eyallampel1/stm32_evb/stm32.kicad_pcb

## KiCad design stm32.kicad_pcb (2025-04-07)

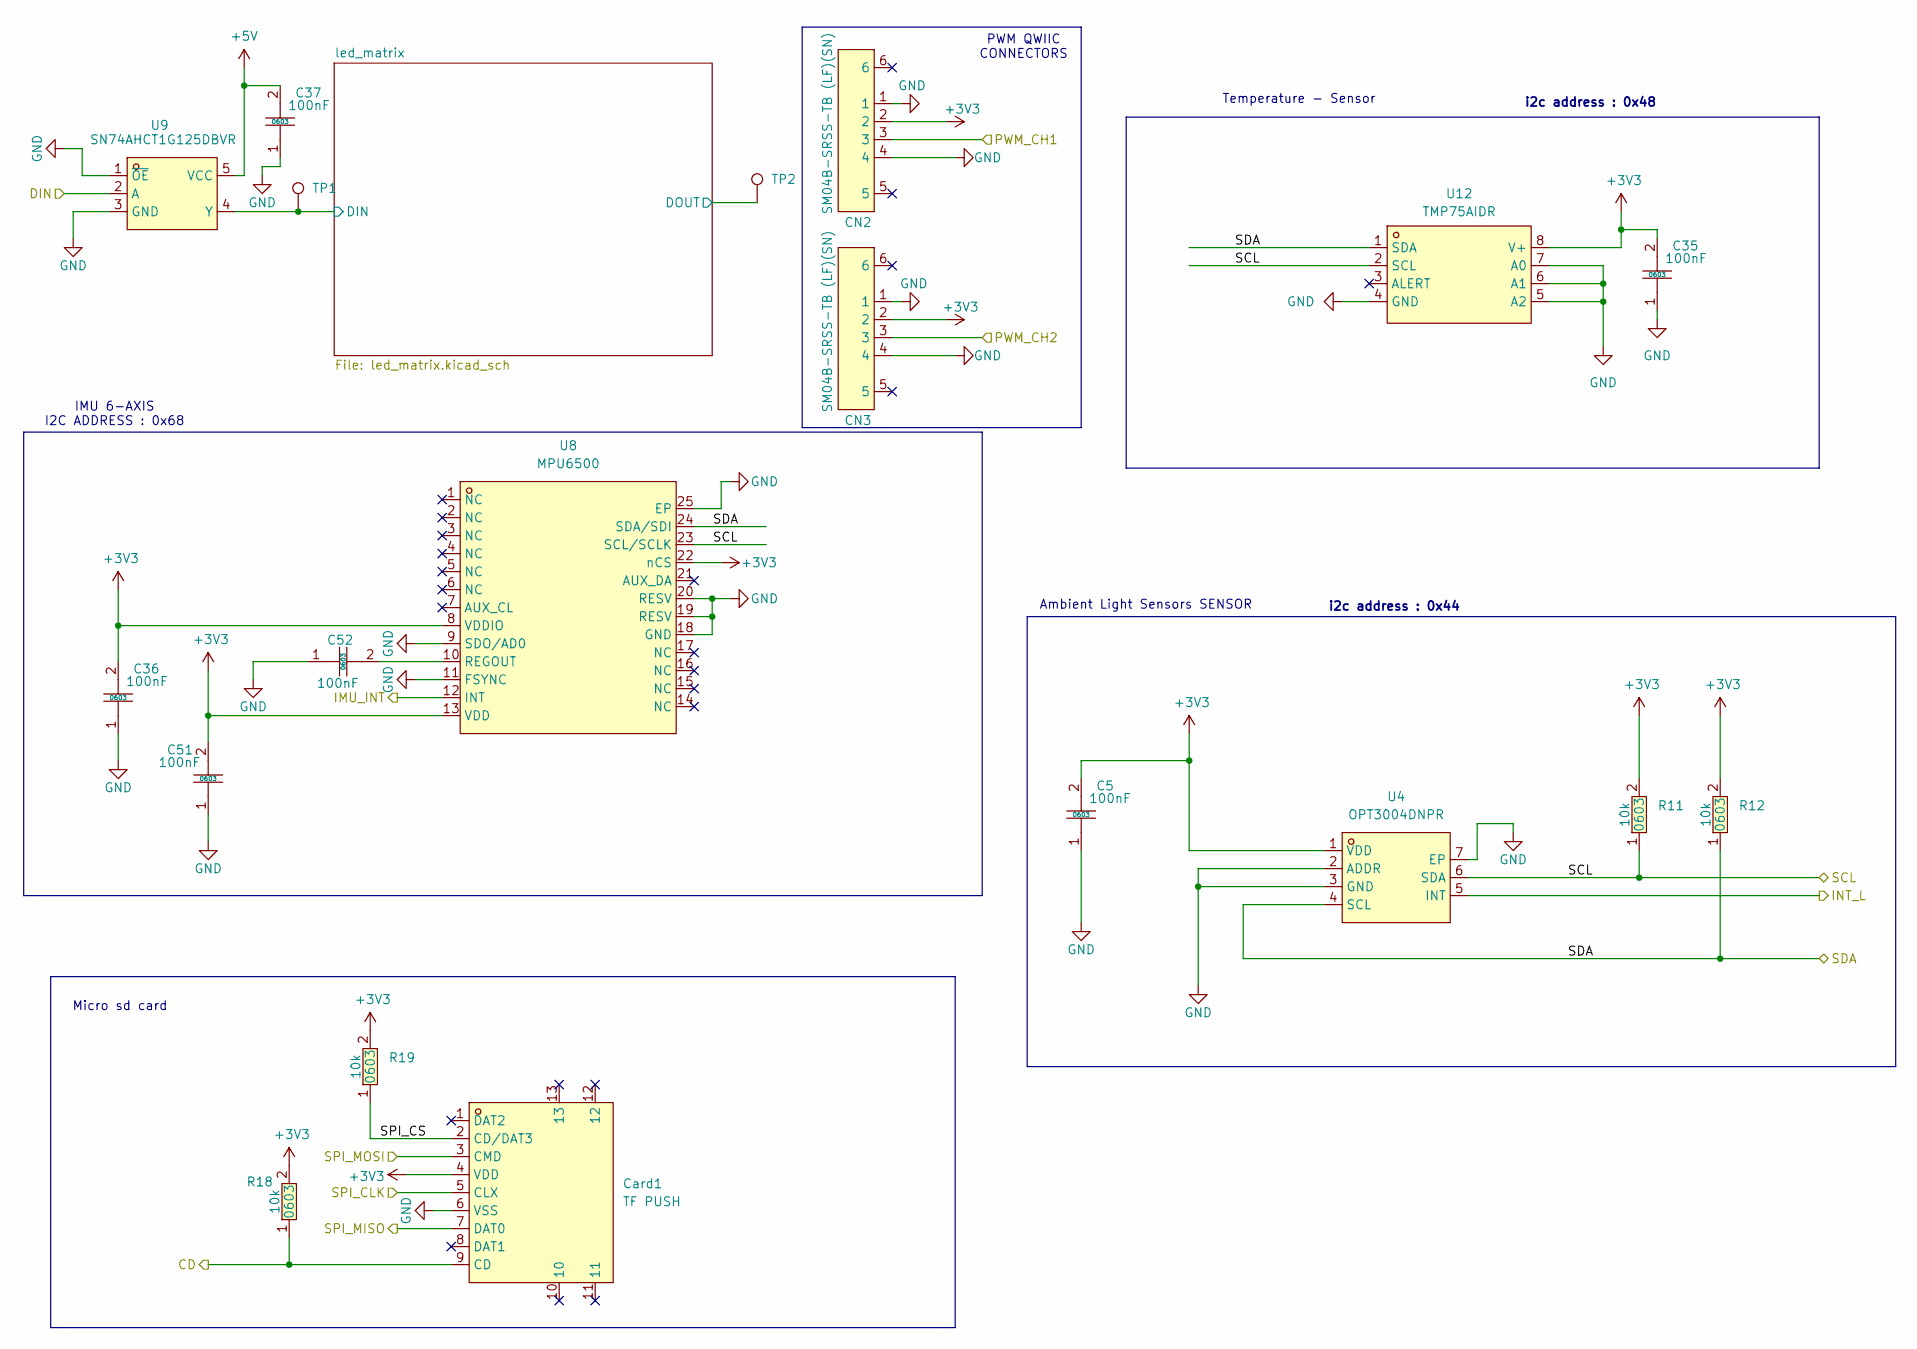
[picture p1: schematic sensors.kicad_sch]

Parts:
C5, C35, C36, C37, C51, C52: CC0603KRX7R9BB104; C0603; LCSC Part C14663
CN2, CN3: SM04B-SRSS-TB (LF)(SN); CONN-SMD_4P-P1.00_SM04B-SRSS-TB-LF-SN; LCSC Part C160404
Card1: TF PUSH; TF-SMD_TF-PUSH; LCSC Part C393941
R11, R12, R18, R19: 0603WAF1002T5E; R0603; LCSC Part C25804
TP1, TP2: TestPoint; TestPoint_Pad_2.0x2.0mm
U4: OPT3004DNPR; WSON-6_L2.0-W2.0-P0.65-TL-EP; LCSC Part C2655153
U8: MPU6500; QFN-24_L3.0-W3.0-P0.40-BL-EP; LCSC Part C50278
U9: SN74AHCT1G125DBVR; SOT-23-5_L3.0-W1.7-P0.95-LS2.8-BR; LCSC Part C7484
U12: TMP75AIDR; SOIC-8_L4.9-W3.9-P1.27-LS6.0-BL; LCSC Part C30389

Connections:
+3V3: C5.2, C35.2, C36.2, C51.2, CN2.2, CN3.2, Card1.4 (VDD), R11.2, R12.2, R18.2, R19.2, U4.1 (VDD), U8.8 (VDDIO), U8.13 (VDD), U8.22 (nCS), U12.8 (V+); also elsewhere on the board
+5V: C37.2, U9.5 (VCC); also elsewhere on the board
/sensors/SCL: R11.1, U4.6 (SDA), U8.23 (SCL/SCLK), U12.2 (SCL); also elsewhere on the board
/sensors/SDA: R12.1, U4.4 (SCL), U8.24 (SDA/SDI), U12.1 (SDA); also elsewhere on the board
/sensors/SPI_CS: Card1.2 (CD/DAT3), R19.1
/sensors/led_matrix/DIN: TP1.1, U9.4 (Y); also elsewhere on the board
/sensors/led_matrix/DOUT: TP2.1; also elsewhere on the board
/stm32_page/IMU_INT: U8.12 (INT); also elsewhere on the board
/stm32_page/PWM_CH1: CN2.3; also elsewhere on the board
/stm32_page/PWM_CH4: CN3.3; also elsewhere on the board
/stm32_page/RGB_LEDS: U9.2 (A); also elsewhere on the board
/stm32_page/SD_CD: Card1.9 (CD), R18.1; also elsewhere on the board
/stm32_page/SPI1_MISO: Card1.7 (DAT0); also elsewhere on the board
/stm32_page/SPI1_MOSI: Card1.3 (CMD); also elsewhere on the board
/stm32_page/SPI1_SCK: Card1.5 (CLX); also elsewhere on the board
/stm32_page/SYS_WKUP1: U4.5 (INT); also elsewhere on the board
GND: C5.1, C35.1, C36.1, C37.1, C51.1, C52.1, CN2.1, CN2.4, CN3.1, CN3.4, Card1.6 (VSS), U4.2 (ADDR), U4.3 (GND), U4.7 (EP), U8.9 (SDO/AD0), U8.11 (FSYNC), U8.18 (GND), U8.19 (RESV), U8.20 (RESV), U8.25 (EP), U9.1 (~OE), U9.3 (GND), U12.4 (GND), U12.5 (A2), U12.6 (A1), U12.7 (A0); also elsewhere on the board
unnamed: C52.2, U8.10 (REGOUT)

Notes on the sheet:
PWM QWIIC CONNECTORS
Temperature - Sensor
i2c address : 0x48
Ambient Light Sensors SENSOR
IMU 6-AXIS I2C ADDRESS : 0x68
i2c address : 0x44
Micro sd card

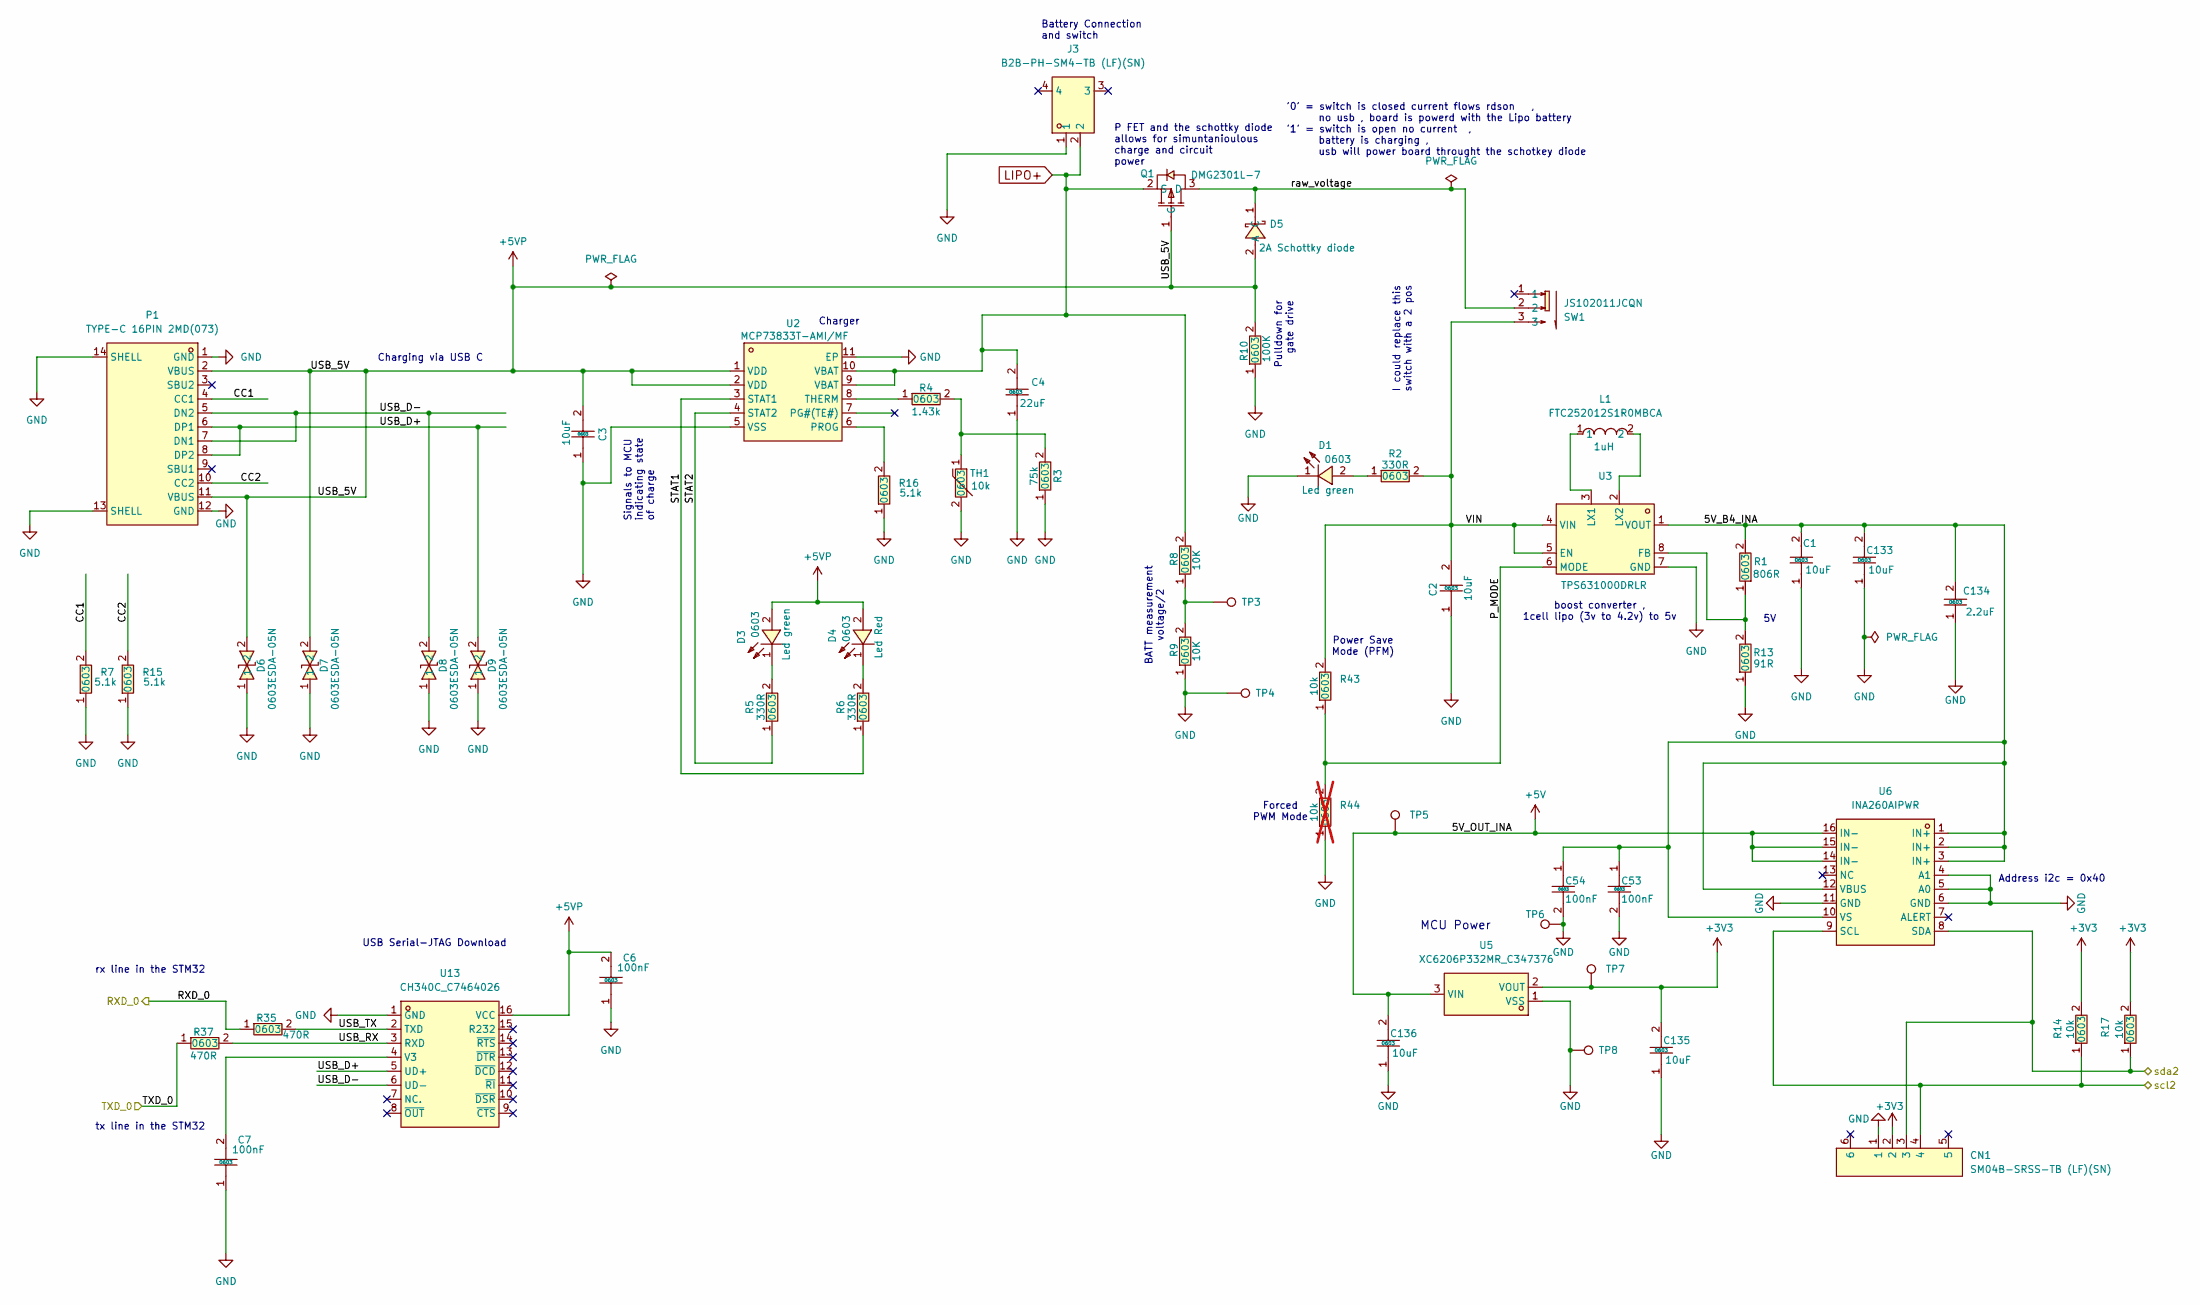
[picture p2: schematic usb_power.kicad_sch]

Parts:
C1, C2, C3, C133, C135, C136: CL10A106KP8NNNC; C0603; LCSC Part C19702
C4: CL10A226MP8NUNE; C0603; LCSC Part C86295
C6, C7, C53, C54: CC0603KRX7R9BB104; C0603; LCSC Part C14663
C134: CL10A225KO8NNNC; C0603; LCSC Part C23630
CN1: SM04B-SRSS-TB (LF)(SN); CONN-SMD_4P-P1.00_SM04B-SRSS-TB-LF-SN; LCSC Part C160404
D1, D3: 0603 Green 509-620mcd; LED0603-RD; LCSC Part C12624
D4: KT-0603R; LED0603-RD; LCSC Part C2286
D5: MBRA210LT3G_C5337989; SMA_L4.3-W2.6-LS5.1-RD; LCSC Part C5337989
D6, D7, D8, D9: 0603ESDA-05N; D0603-BI; LCSC Part C316054
J3: B2B-PH-SM4-TB (LF)(SN); CONN-SMD_B2B-PH-SM4-TB-LF-SN; LCSC Part C265003
L1: FTC252012S1R0MBCA; IND-SMD_L2.5-W2.0-VLS252012CX-150M; LCSC Part C5832370
P1: TYPE-C 16PIN 2MD(073); USB-C-SMD_TYPE-C-6PIN-2MD-073; LCSC Part C2765186
Q1: DMG2301L-7; SOT-23-3_L2.9-W1.3-P1.90-LS2.4-BR; LCSC Part C102619
R1: 0603WAF8060T5E; R0603; LCSC Part C23116
R2, R5, R6: 0603WAF3300T5E; R0603; LCSC Part C23138
R3: 0603WAF7502T5E; R0603; LCSC Part C23242
R4: 0603WAF1431T5E; R0603; LCSC Part C22840
R7, R15, R16: 0603WAF5101T5E; R0603; LCSC Part C23186
R8, R9, R14, R17, R43: 0603WAF1002T5E; R0603; LCSC Part C25804
R10: 0603WAF1003T5E; R0603; LCSC Part C25803
R13: 0603WAF910JT5E; R0603; LCSC Part C351621
R35, R37: 0603WAF4700T5E; R0603; LCSC Part C23179
R44: 0603WAF1002T5E; R0603; LCSC Part C25804; not fitted
SW1: JS102011JCQN; SW-SMD_JS102011JCQN; LCSC Part C221659
TH1: NCP18XH103F03RB; R0603; LCSC Part C13564
TP3, TP4, TP5, TP6, TP7, TP8: TestPoint; TestPoint_Pad_2.0x2.0mm
U2: MCP73833T-AMI/MF; DFN-10_L3.0-W3.0-P0.50-BL-EP-1; LCSC Part C340160
U3: TPS631000DRLR; SOT-583-8_L2.1-W1.2-P0.50-LS1.6-BL; LCSC Part C5219190
U5: XC6206P332MR_C347376; SOT-23-3_L3.0-W1.7-P0.95-LS2.9-BR; LCSC Part C347376
U6: INA260AIPWR; TSSOP-16_L5.0-W4.4-P0.65-LS6.4-BL-1; LCSC Part C2155885
U13: CH340C_C7464026; SOP-16_L10.0-W3.9-P1.27-LS6.0-BL; LCSC Part C7464026

Connections:
+3V3: C135.2, CN1.2, R14.2, R17.2, TP7.1, U5.2 (VOUT); also elsewhere on the board
+5V: C136.2, TP5.1, U5.3 (VIN), U6.14 (IN-), U6.15 (IN-), U6.16 (IN-); also elsewhere on the board
+5VP: C3.2, C6.2, D3.2 (A), D4.2 (A), D5.2 (A), D6.2, D7.2, P1.2 (VBUS), P1.11 (VBUS), Q1.1 (G), R10.2, U2.1 (VDD), U2.2 (VDD), U13.16 (VCC)
/USB/5V_B4_INA: C1.2, C53.1, C54.1, C133.2, C134.2, R1.2, U3.1 (VOUT), U6.1 (IN+), U6.2 (IN+), U6.3 (IN+), U6.10 (VS), U6.12 (VBUS)
/USB/CC1: P1.4 (CC1), R7.2
/USB/CC2: P1.10 (CC2), R15.2
/USB/P_MODE: R43.1, R44.2, U3.6 (MODE)
/USB/RXD_0: R35.1; also elsewhere on the board
/USB/STAT1: R6.1, U2.3 (STAT1)
/USB/STAT2: R5.1, U2.4 (STAT2)
/USB/TXD_0: R37.1; also elsewhere on the board
/USB/USB_D+: D9.2, P1.6 (DP1), P1.8 (DP2), U13.5 (UD+)
/USB/USB_D-: D8.2, P1.5 (DN2), P1.7 (DN1), U13.6 (UD-)
/USB/USB_RX: R37.2, U13.3 (RXD)
/USB/USB_TX: R35.2, U13.2 (TXD)
/USB/VIN: C2.2, R2.2, R43.2, SW1.3, U3.4 (VIN), U3.5 (EN)
/USB/raw_voltage: D5.1 (C), Q1.3 (D), SW1.2
/stm32_page/I2C3_SCL: CN1.4, R14.1, U6.9 (SCL); also elsewhere on the board
/stm32_page/I2C3_SDA: CN1.3, R17.1, U6.8 (SDA); also elsewhere on the board
GND: C1.1, C2.1, C3.1, C4.1, C6.1, C7.1, C53.2, C54.2, C133.1, C134.1, C135.1, C136.1, CN1.1, D1.1 (K), D6.1, D7.1, D8.1, D9.1, J3.1, P1.1 (GND), P1.12 (GND), P1.13 (SHELL), P1.14 (SHELL), R3.1, R7.1, R9.1, R10.1, R13.1, R15.1, R16.1, R44.1, TH1.2, TP4.1, TP6.1, TP8.1, U2.5 (VSS), U2.11 (EP), U3.7 (GND), U5.1 (VSS), U6.4 (A1), U6.5 (A0), U6.6 (GND), U6.11 (GND), U13.1 (GND); also elsewhere on the board
LIPO+: C4.2, J3.2, Q1.2 (S), R8.2, U2.9 (VBAT), U2.10 (VBAT)
unnamed: D1.2 (A), R2.1
unnamed: D3.1 (K), R5.2
unnamed: D4.1 (K), R6.2
unnamed: R3.2, R4.2, TH1.1
unnamed: R8.1, R9.2, TP3.1
unnamed: R16.2, U2.6 (PROG)
unnamed: R4.1, U2.8 (THERM)
unnamed: R1.1, R13.2, U3.8 (FB)
unnamed: L1.1, U3.3 (LX1)
unnamed: L1.2, U3.2 (LX2)
unnamed: C7.2, U13.4 (V3)

Notes on the sheet:
Charger
Forced PWM Mode
rx line in the STM32
P FET and the schottky diode allows for simuntanioulous charge and circuit power
Pulldown for gate drive
USB Serial-JTAG Download
'0' = switch is closed current flows rdson , no usb , board is powerd with the Lipo battery '1' = switch is open no current , battery is charging , usb will power board throught the schotkey diode
boost converter , 1cell lipo (3v to 4.2v) to 5v
BATT measurement voltage/2
Power Save Mode (PFM)
Battery Connection and switch
Address i2c = 0x40
tx line in the STM32
I could replace this switch with a 2 pos
Signals to MCU indicating state of charge
MCU Power
Charging via USB C

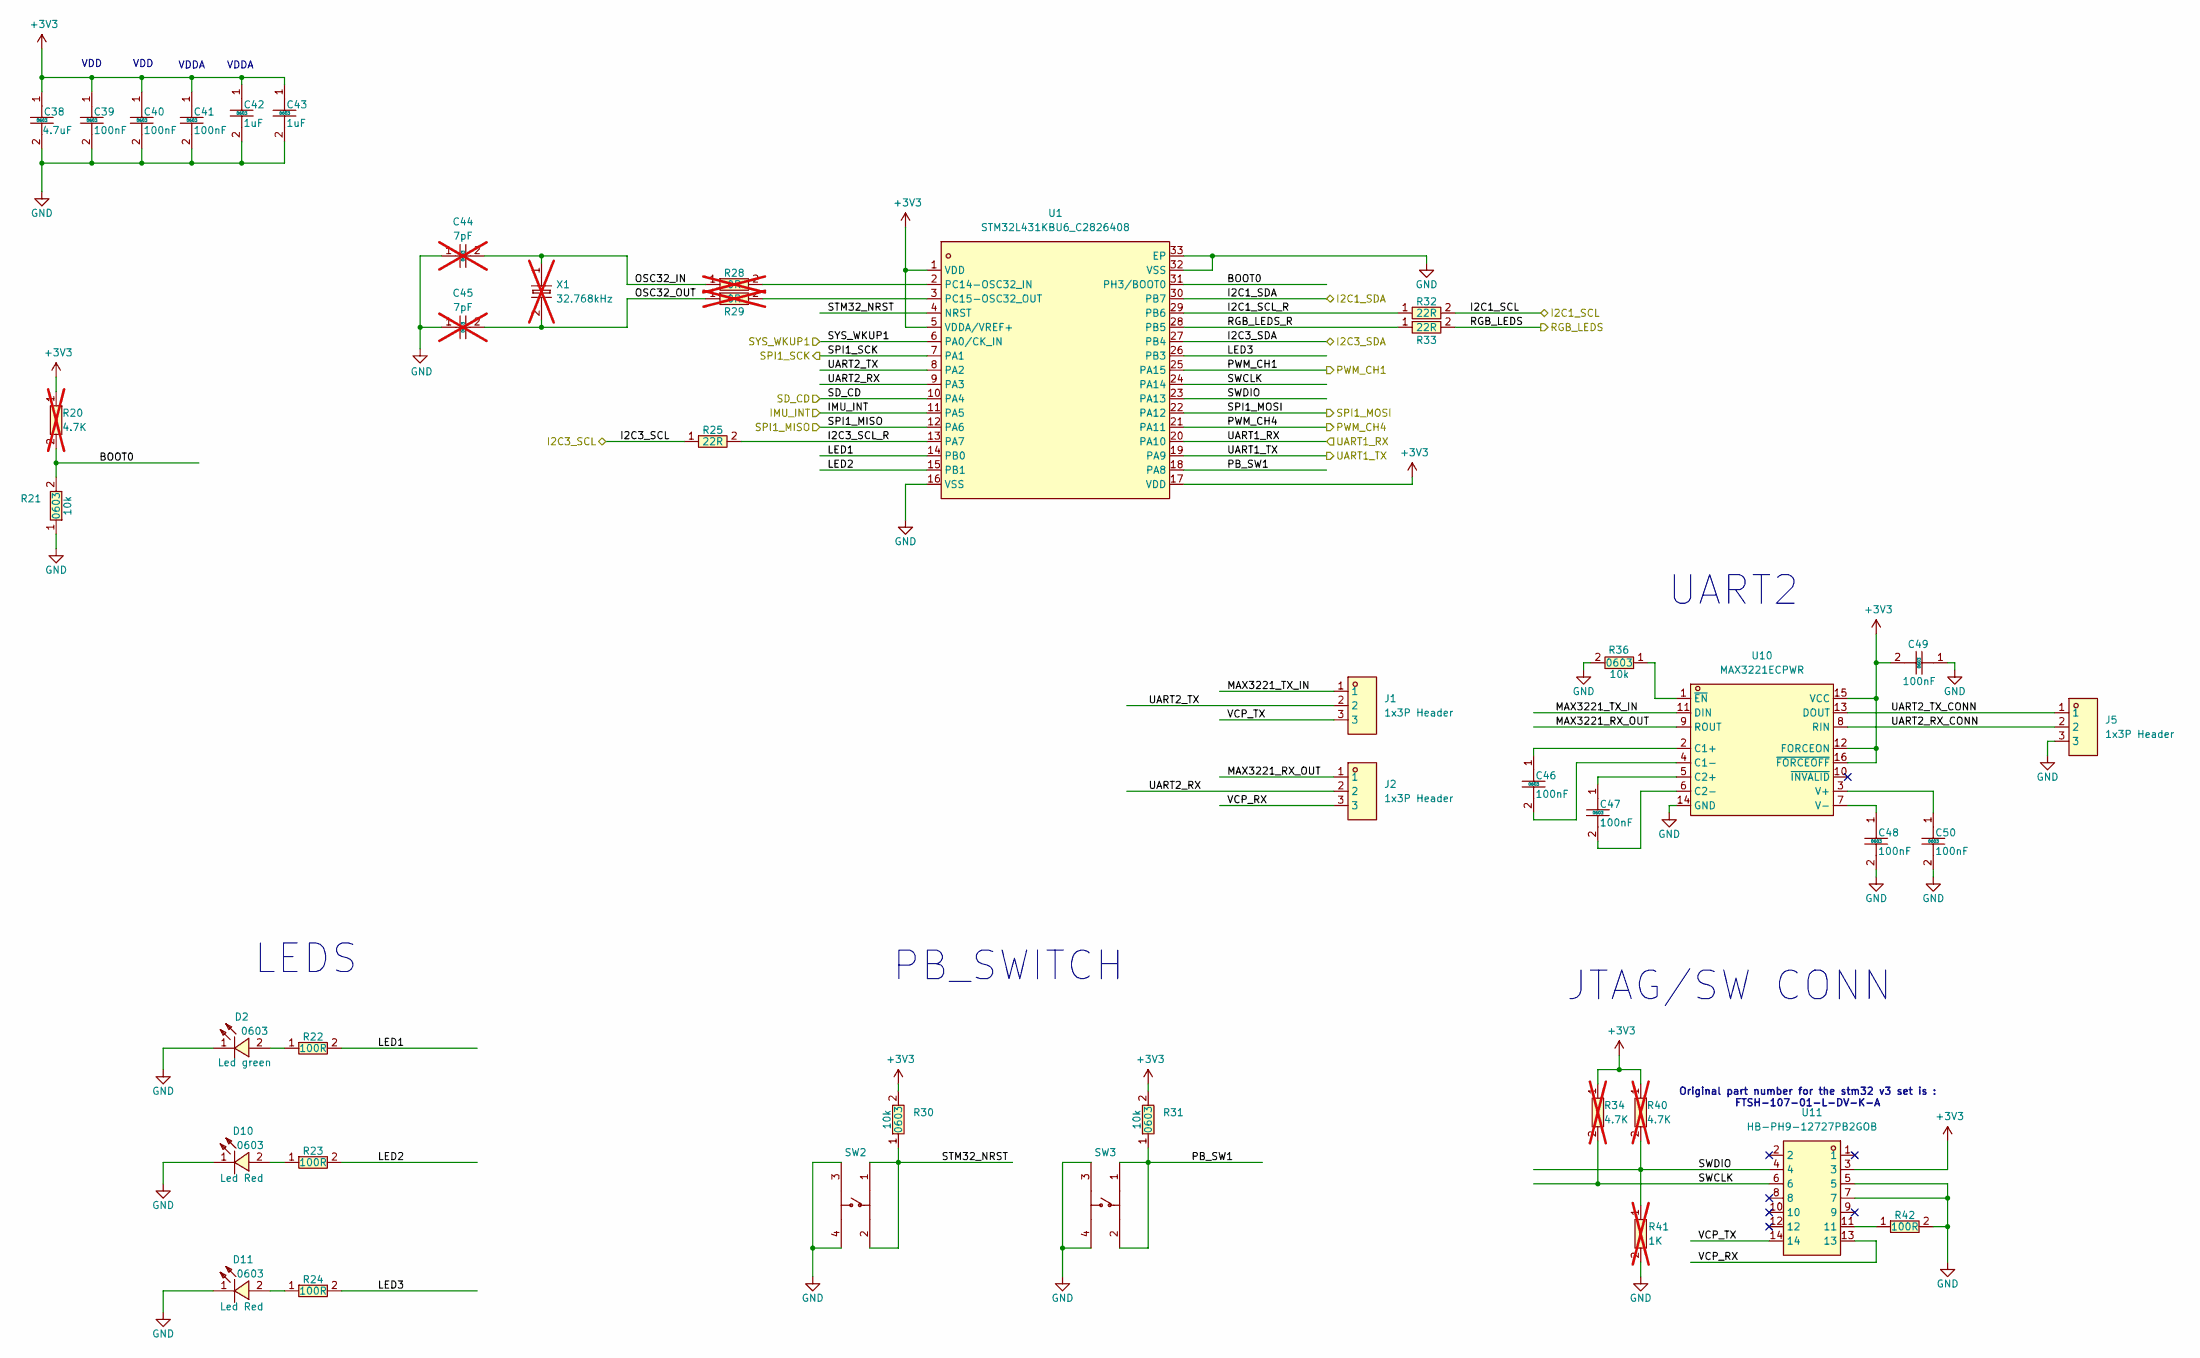
[picture p3: schematic stm32_page.kicad_sch]

Parts:
C38: CL10A475KO8NNNC; C0603; LCSC Part C19666
C39, C40, C41, C46, C47, C48, C49, C50: CC0603KRX7R9BB104; C0603; LCSC Part C14663
C42, C43: CL10A105KB8NNNC; C0603; LCSC Part C15849
C44, C45: 0603CG7R0C500NT; C0603; LCSC Part C1682; not fitted
D2: 0603 Green 509-620mcd; LED0603-RD; LCSC Part C12624
D10, D11: KT-0603R; LED0603-RD; LCSC Part C2286
J1, J2, J5: PZ254V-11-03P_C2937625; HDR-TH_3P-P2.54-V-M; LCSC Part C2937625
R20, R34, R40: 0603WAF4701T5E; R0603; LCSC Part C23162; not fitted
R21, R30, R31, R36: 0603WAF1002T5E; R0603; LCSC Part C25804
R22, R23, R24, R42: 0603WAF1000T5E; R0603; LCSC Part C22775
R25, R32, R33: 0603WAF220JT5E; R0603; LCSC Part C23345
R28, R29: 0603WAF0000T5E; R0603; LCSC Part C21189; not fitted
R41: 0603WAF1001T5E; R0603; LCSC Part C21190; not fitted
SW2, SW3: 6.0*6.0*6.0; SW-SMD_4P-L6.0-W6.0-P4.50-LS8.6; LCSC Part C5127964
U1: STM32L431KBU6_C2826408; QFN-32_L5.0-W5.0-P0.50-TL-EP3.5; LCSC Part C2826408
U10: MAX3221ECPWR; TSSOP-16_L5.0-W4.4-P0.65-LS6.4-BL; LCSC Part C350553
U11: HB-PH9-12727PB2GOB; HDR-SMD_14P-P1.27-V-M-R2-C7-LS5.5; LCSC Part C6332251
X1: SC-32S32.768kHz20PPM7pF; OSC-SMD_L3.2-W1.5; LCSC Part C97604; not fitted

Connections:
+3V3: C38.1, C39.1, C40.1, C41.1, C42.1, C43.1, C49.2, R20.1, R30.2, R31.2, R34.1, R40.1, U1.1 (VDD), U1.5 (VDDA/VREF+), U1.17 (VDD), U10.12 (FORCEON), U10.15 (VCC), U10.16 (~FORCEOFF), U11.3; also elsewhere on the board
/USB/RXD_0: U1.20 (PA10); also elsewhere on the board
/USB/TXD_0: U1.19 (PA9); also elsewhere on the board
/sensors/SCL: R32.2; also elsewhere on the board
/sensors/SDA: U1.30 (PB7); also elsewhere on the board
/stm32_page/BOOT0: R20.2, R21.2, U1.31 (PH3/BOOT0)
/stm32_page/I2C1_SCL_R: R32.1, U1.29 (PB6)
/stm32_page/I2C3_SCL: R25.1; also elsewhere on the board
/stm32_page/I2C3_SCL_R: R25.2, U1.13 (PA7)
/stm32_page/I2C3_SDA: U1.27 (PB4); also elsewhere on the board
/stm32_page/IMU_INT: U1.11 (PA5); also elsewhere on the board
/stm32_page/LED1: R22.2, U1.14 (PB0)
/stm32_page/LED2: R23.2, U1.15 (PB1)
/stm32_page/LED3: R24.2, U1.26 (PB3)
/stm32_page/MAX3221_RX_OUT: J2.1, U10.9 (ROUT)
/stm32_page/MAX3221_TX_IN: J1.1, U10.11 (DIN)
/stm32_page/OSC32_IN: C44.2, R28.1, X1.1
/stm32_page/OSC32_OUT: C45.2, R29.1, X1.2
/stm32_page/PB_SW1: R31.1, SW3.1, SW3.2, U1.18 (PA8)
/stm32_page/PWM_CH1: U1.25 (PA15); also elsewhere on the board
/stm32_page/PWM_CH4: U1.21 (PA11); also elsewhere on the board
/stm32_page/RGB_LEDS: R33.2; also elsewhere on the board
/stm32_page/RGB_LEDS_R: R33.1, U1.28 (PB5)
/stm32_page/SD_CD: U1.10 (PA4); also elsewhere on the board
/stm32_page/SPI1_MISO: U1.12 (PA6); also elsewhere on the board
/stm32_page/SPI1_MOSI: U1.22 (PA12); also elsewhere on the board
/stm32_page/SPI1_SCK: U1.7 (PA1); also elsewhere on the board
/stm32_page/STM32_NRST: R30.1, SW2.1, SW2.2, U1.4 (NRST)
/stm32_page/SWCLK: R34.2, U1.24 (PA14), U11.6
/stm32_page/SWDIO: R40.2, R41.1, U1.23 (PA13), U11.4
/stm32_page/SYS_WKUP1: U1.6 (PA0/CK_IN); also elsewhere on the board
/stm32_page/UART2_RX: J2.2, U1.9 (PA3)
/stm32_page/UART2_RX_CONN: J5.2, U10.8 (RIN)
/stm32_page/UART2_TX: J1.2, U1.8 (PA2)
/stm32_page/UART2_TX_CONN: J5.1, U10.13 (DOUT)
/stm32_page/VCP_RX: J2.3, U11.13
/stm32_page/VCP_TX: J1.3, U11.14
GND: C38.2, C39.2, C40.2, C41.2, C42.2, C43.2, C44.1, C45.1, C48.2, C49.1, C50.2, D2.1 (K), D10.1 (K), D11.1 (K), J5.3, R21.1, R36.2, R41.2, R42.2, SW2.3, SW2.4, SW3.3, SW3.4, U1.16 (VSS), U1.32 (VSS), U1.33 (EP), U10.14 (GND), U11.5, U11.7; also elsewhere on the board
unnamed: D2.2 (A), R22.1
unnamed: D10.2 (A), R23.1
unnamed: D11.2 (A), R24.1
unnamed: R42.1, U11.11
unnamed: R28.2, U1.2 (PC14-OSC32_IN)
unnamed: R29.2, U1.3 (PC15-OSC32_OUT)
unnamed: C46.1, U10.2 (C1+)
unnamed: C46.2, U10.4 (C1-)
unnamed: C47.1, U10.5 (C2+)
unnamed: C47.2, U10.6 (C2-)
unnamed: C50.1, U10.3 (V+)
unnamed: C48.1, U10.7 (V-)
unnamed: R36.1, U10.1 (~EN)

Notes on the sheet:
PB_SWITCH
LEDS
VDD
JTAG/SW CONN
VDDA
Original part number for the stm32 v3 set is : FTSH-107-01-L-DV-K-A
UART2

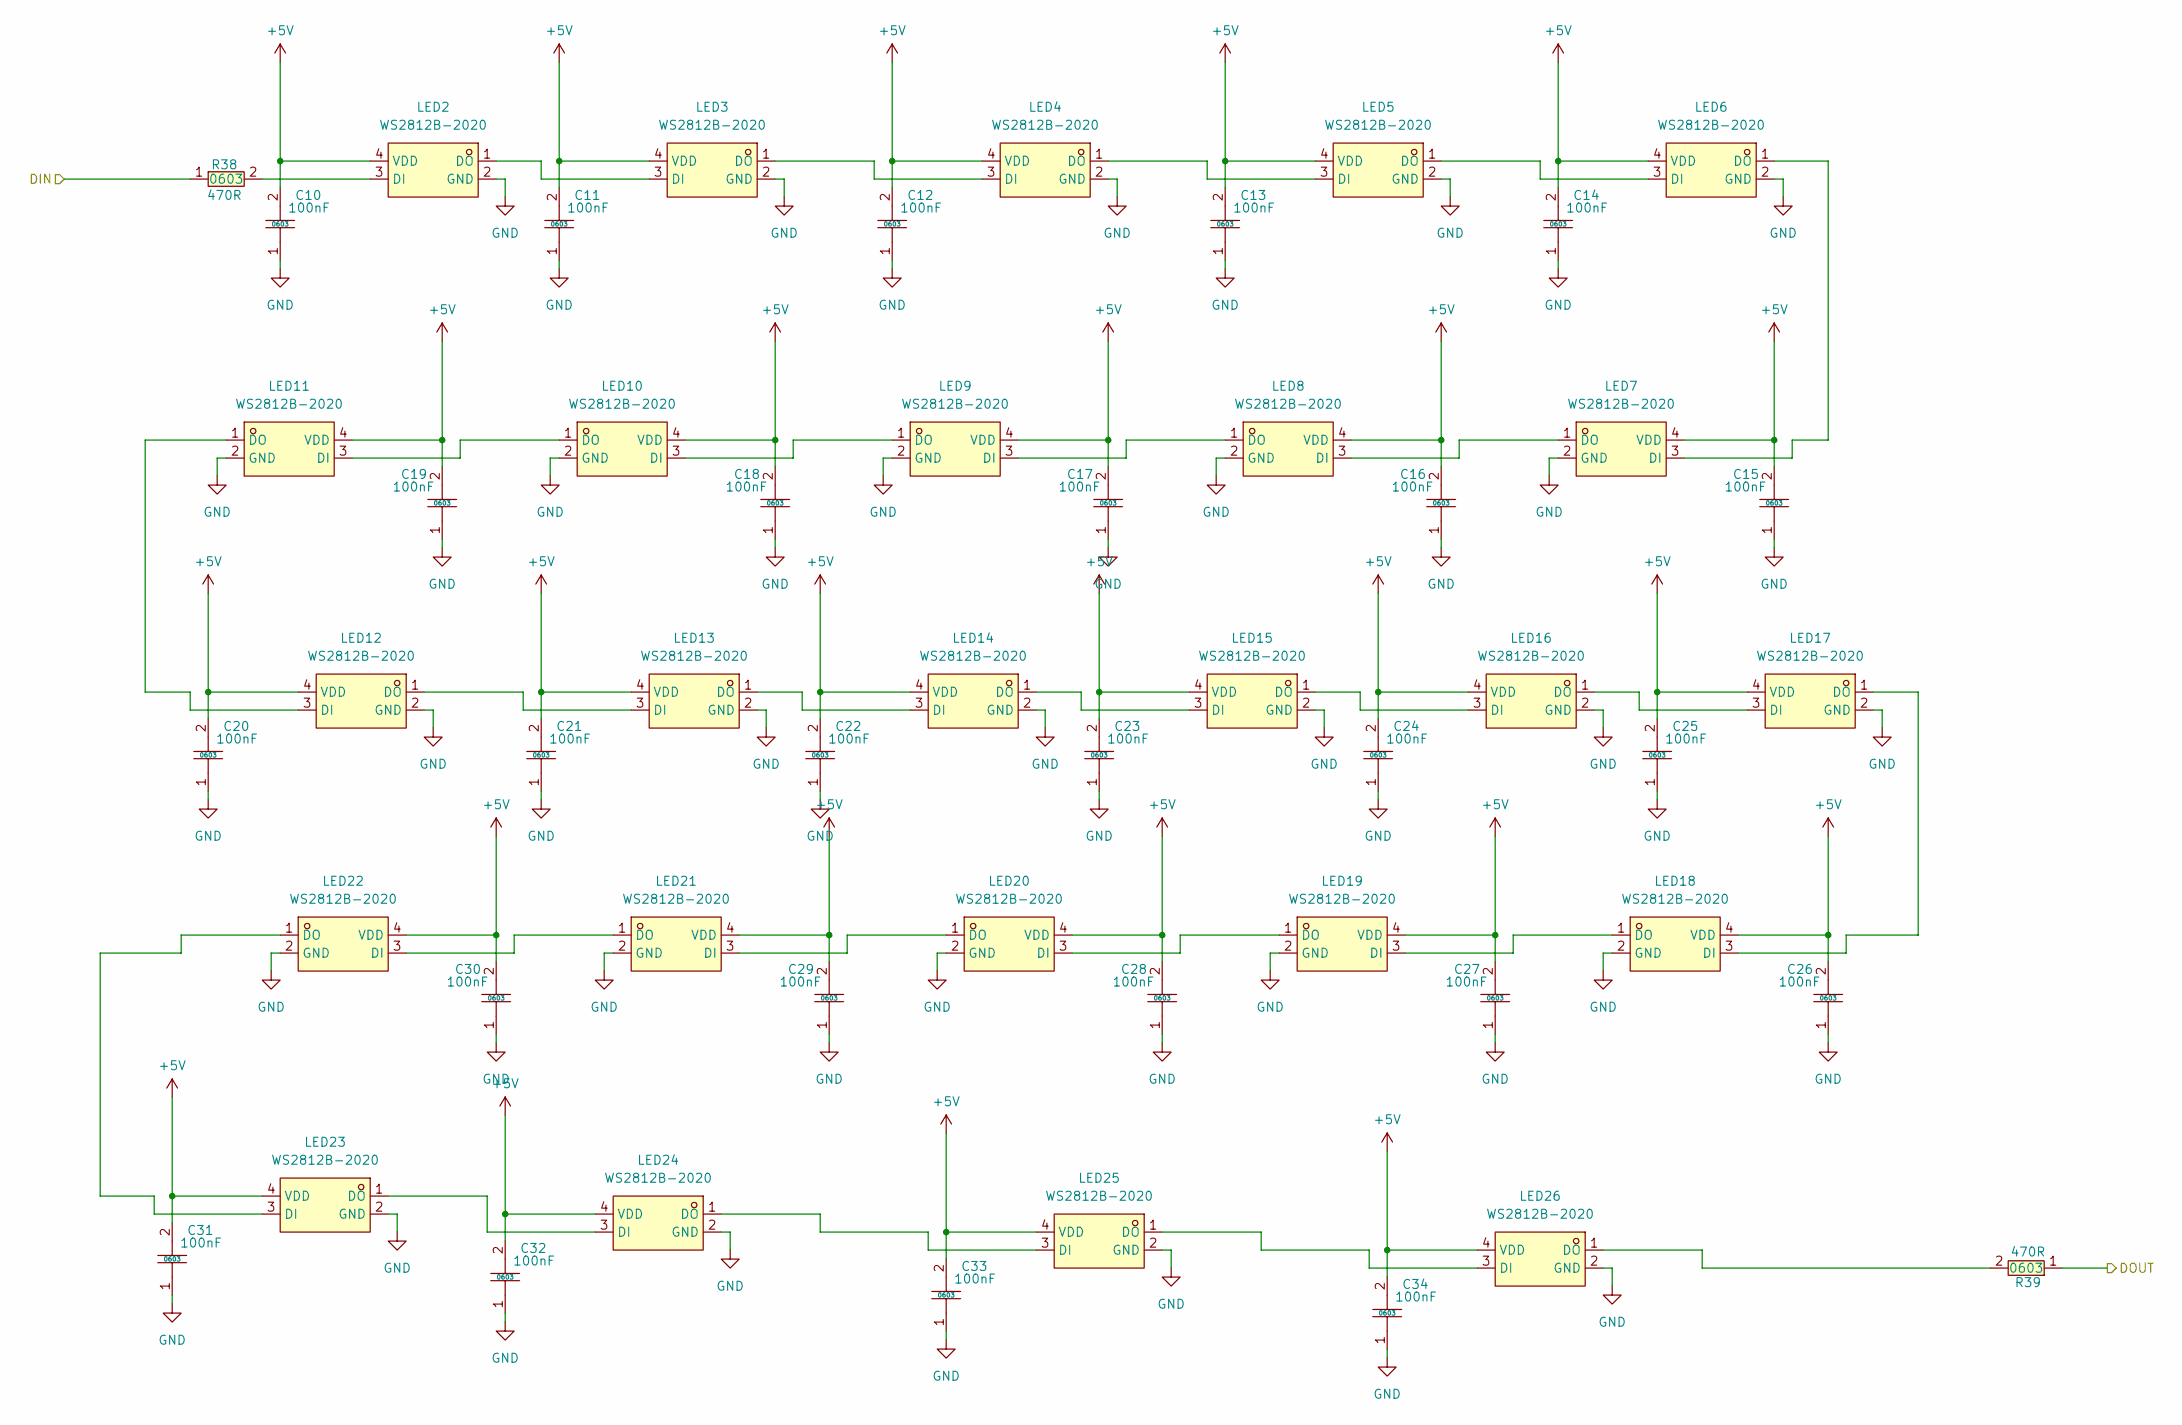
[picture p4: schematic led_matrix.kicad_sch]

Parts:
C10, C11, C12, C13, C14, C15, C16, C17, C18, C19, C20, C21, C22, C23, C24, C25, C26, C27, C28, C29, C30, C31, C32, C33, C34: CC0603KRX7R9BB104; C0603; LCSC Part C14663
LED2, LED3, LED4, LED5, LED6, LED7, LED8, LED9, LED10, LED11, LED12, LED13, LED14, LED15, LED16, LED17, LED18, LED19, LED20, LED21, LED22, LED23, LED24, LED25, LED26: WS2812B-2020; LED-SMD_4P-L2.0-W2.0-TL_WS2812B-2020; LCSC Part C965555
R38, R39: 0603WAF4700T5E; R0603; LCSC Part C23179

Connections:
+5V: C10.2, C11.2, C12.2, C13.2, C14.2, C15.2, C16.2, C17.2, C18.2, C19.2, C20.2, C21.2, C22.2, C23.2, C24.2, C25.2, C26.2, C27.2, C28.2, C29.2, C30.2, C31.2, C32.2, C33.2, C34.2, LED2.4 (VDD), LED3.4 (VDD), LED4.4 (VDD), LED5.4 (VDD), LED6.4 (VDD), LED7.4 (VDD), LED8.4 (VDD), LED9.4 (VDD), LED10.4 (VDD), LED11.4 (VDD), LED12.4 (VDD), LED13.4 (VDD), LED14.4 (VDD), LED15.4 (VDD), LED16.4 (VDD), LED17.4 (VDD), LED18.4 (VDD), LED19.4 (VDD), LED20.4 (VDD), LED21.4 (VDD), LED22.4 (VDD), LED23.4 (VDD), LED24.4 (VDD), LED25.4 (VDD), LED26.4 (VDD); also elsewhere on the board
/sensors/led_matrix/DIN: R38.1; also elsewhere on the board
/sensors/led_matrix/DOUT: R39.1; also elsewhere on the board
GND: C10.1, C11.1, C12.1, C13.1, C14.1, C15.1, C16.1, C17.1, C18.1, C19.1, C20.1, C21.1, C22.1, C23.1, C24.1, C25.1, C26.1, C27.1, C28.1, C29.1, C30.1, C31.1, C32.1, C33.1, C34.1, LED2.2 (GND), LED3.2 (GND), LED4.2 (GND), LED5.2 (GND), LED6.2 (GND), LED7.2 (GND), LED8.2 (GND), LED9.2 (GND), LED10.2 (GND), LED11.2 (GND), LED12.2 (GND), LED13.2 (GND), LED14.2 (GND), LED15.2 (GND), LED16.2 (GND), LED17.2 (GND), LED18.2 (GND), LED19.2 (GND), LED20.2 (GND), LED21.2 (GND), LED22.2 (GND), LED23.2 (GND), LED24.2 (GND), LED25.2 (GND), LED26.2 (GND); also elsewhere on the board
unnamed: LED2.3 (DI), R38.2
unnamed: LED2.1 (DO), LED3.3 (DI)
unnamed: LED3.1 (DO), LED4.3 (DI)
unnamed: LED4.1 (DO), LED5.3 (DI)
unnamed: LED5.1 (DO), LED6.3 (DI)
unnamed: LED6.1 (DO), LED7.3 (DI)
unnamed: LED7.1 (DO), LED8.3 (DI)
unnamed: LED8.1 (DO), LED9.3 (DI)
unnamed: LED9.1 (DO), LED10.3 (DI)
unnamed: LED10.1 (DO), LED11.3 (DI)
unnamed: LED11.1 (DO), LED12.3 (DI)
unnamed: LED12.1 (DO), LED13.3 (DI)
unnamed: LED13.1 (DO), LED14.3 (DI)
unnamed: LED14.1 (DO), LED15.3 (DI)
unnamed: LED15.1 (DO), LED16.3 (DI)
unnamed: LED16.1 (DO), LED17.3 (DI)
unnamed: LED17.1 (DO), LED18.3 (DI)
unnamed: LED18.1 (DO), LED19.3 (DI)
unnamed: LED19.1 (DO), LED20.3 (DI)
unnamed: LED20.1 (DO), LED21.3 (DI)
unnamed: LED21.1 (DO), LED22.3 (DI)
unnamed: LED22.1 (DO), LED23.3 (DI)
unnamed: LED23.1 (DO), LED24.3 (DI)
unnamed: LED24.1 (DO), LED25.3 (DI)
unnamed: LED25.1 (DO), LED26.3 (DI)
unnamed: LED26.1 (DO), R39.2

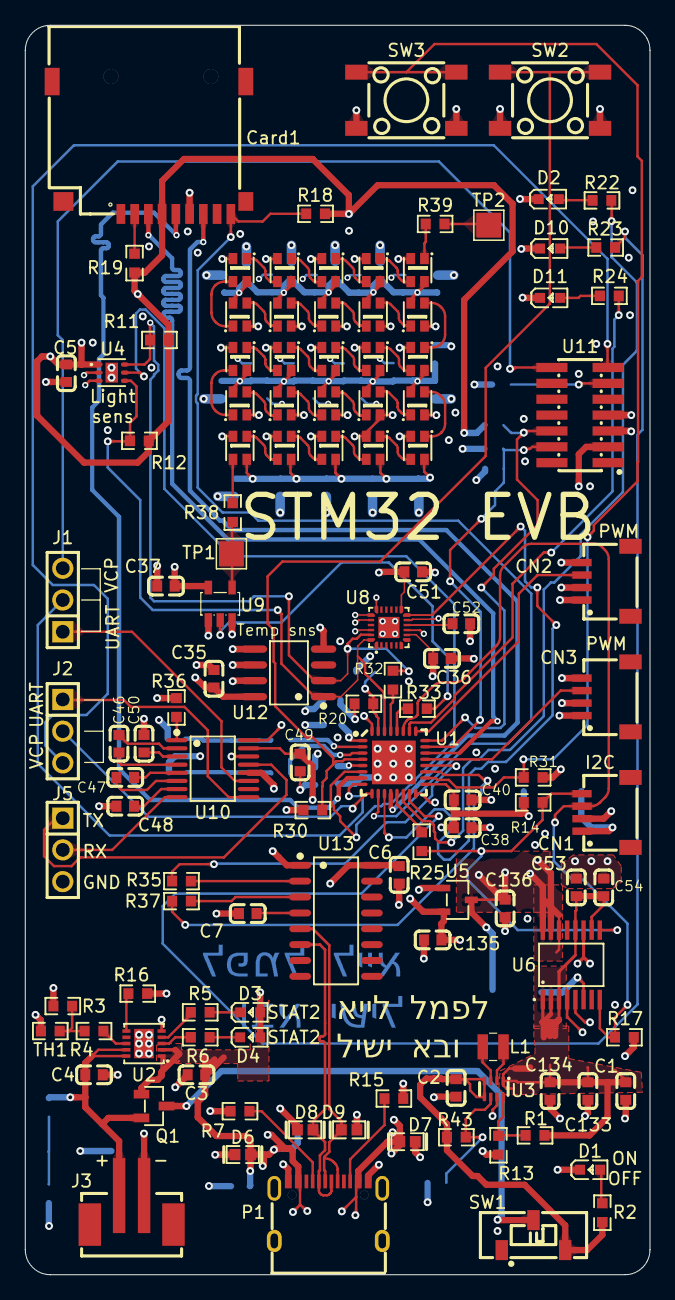
[picture p5: board stm32.kicad_pcb from above]

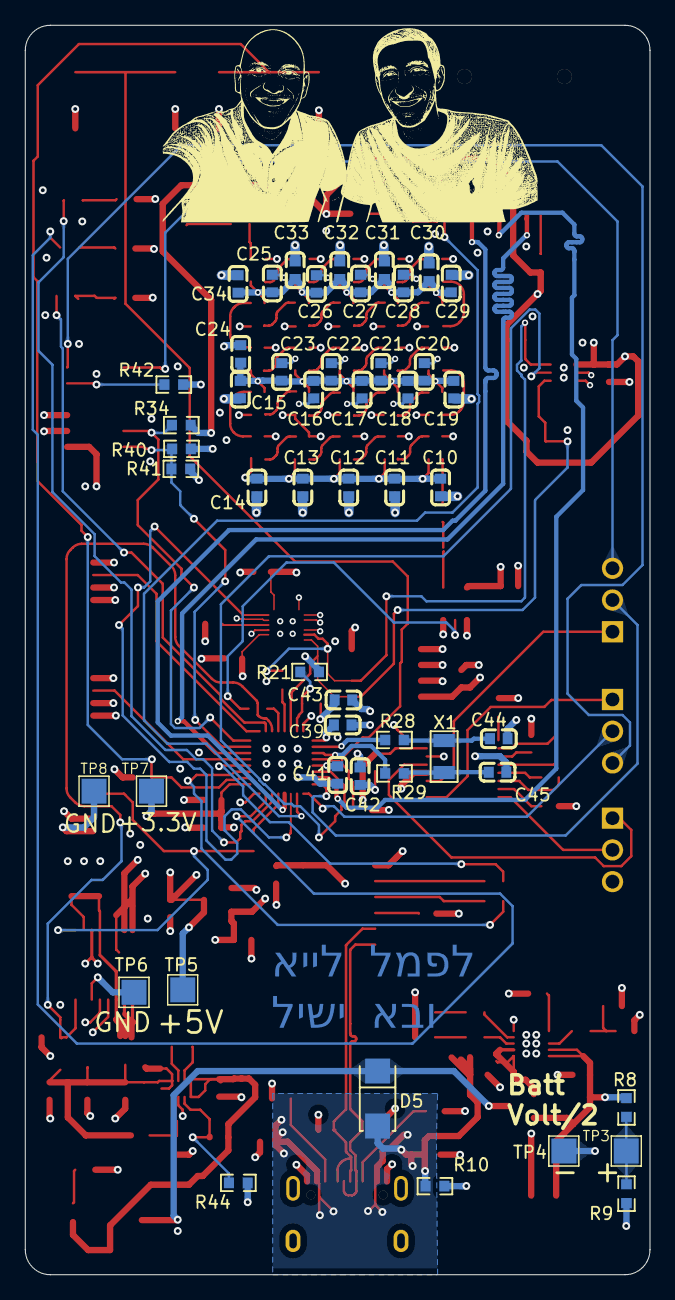
[picture p6: board stm32.kicad_pcb from below]

Board: 4 copper layers, 50.0 x 100.0 mm, 170 parts (50 on the bottom side), 107 nets.
