eyallampel1/stm32_evb/(commit log)

2025-03-25 test lishau
    [stm32_page.kicad_sch]
2025-03-26 Added usb block - still need to check
    [usb_power.kicad_sch]
2025-03-26 adding jtag and power cap
    [stm32_page.kicad_sch]
2025-03-26 Added some sensors and ch340
    [sensors.kicad_sch, usb_power.kicad_sch]
2025-03-27 updating res and cap to 0603, adding OSC32 DRP, JTAG done, power done
    [stm32_page.kicad_sch, usb_power.kicad_sch]
2025-03-27 Added some sensors and current sensor
    [sensors.kicad_sch, usb_power.kicad_sch]
2025-03-28 Added led matrix and ina260
    [led_matrix.kicad_sch, sensors.kicad_sch, stm32.kicad_pcb, usb_power.kicad_sch]
2025-03-30 Cap updated again to basic parts
    [stm32_page.kicad_sch, usb_power.kicad_sch]
2025-03-30 Add IO pinout - 2 I2C, 2UART, 1 SPI, LEDs, switches,2 interupts,RST
    [stm32_page.kicad_sch]
2025-03-30 Add LEDs,22r to I2C, UART conv, power conn, remove JTAG to SW debug
    [stm32_page.kicad_sch]
2025-03-30 Finished sensor / usb block
    [sensors.kicad_sch, usb_power.kicad_sch]
2025-03-30 add SD_CD, PB_SW for NRST, 22R for RGB, 1X3 headers for uart and VCP option, block ports
    [stm32_page.kicad_sch]
2025-03-30 Add PWM and LED. After this commit I will connect the TOP
    [stm32_page.kicad_sch, usb_power.kicad_sch]
2025-03-30 Finished schematic need to check , before layout
    [sensors.kicad_sch, stm32.kicad_sch, stm32_page.kicad_sch, usb_power.kicad_sch]
2025-03-31 replaced part for lower cost
    [sensors.kicad_sch, stm32_page.kicad_sch, usb_power.kicad_sch]
2025-04-02 Changed lga sensors to cheap qfn soic8 package
    [sensors.kicad_sch]
2025-04-02 removed 1uf cap
    [stm32_page.kicad_sch]
2025-04-02 Changed a bit component that where out of stock
    [sensors.kicad_sch, stm32_page.kicad_sch, usb_power.kicad_sch]
2025-04-03 Added pull up / pull down on mode pin tps
    [sensors.kicad_sch, stm32.kicad_pcb, usb_power.kicad_sch]
2025-04-03 Added missing filter caps on ina260
    [stm32.kicad_pcb, usb_power.kicad_sch]
2025-04-03 Removed VBAT wrong text on stm32 page
    [stm32_page.kicad_sch]
2025-04-04 Advanced placement , minor schem changes
    [stm32.kicad_pcb, stm32_page.kicad_sch, usb_power.kicad_sch]
2025-04-05 Finished placement , added few TP's
    [sensors.kicad_sch, stm32.kicad_pcb, stm32.kicad_sch, stm32_page.kicad_sch, usb_power.kicad_sch]
2025-04-05 WIP routing still not finished
    [stm32.kicad_pcb, usb_power.kicad_sch]
2025-04-05 Finished routing
    [stm32.kicad_pcb]
2025-04-06 Swap L4 with L3 and finished routing
    [stm32.kicad_pcb, usb_power.kicad_sch]
2025-04-06 Working on drc in pcb
    [stm32.kicad_pcb]
2025-04-06 Fixed some drc errors
    [stm32.kicad_pcb]
2025-04-06 Finished board ,now to production
    [stm32.kicad_pcb, usb_power.kicad_sch]
2025-04-07 imporve some nets
    [stm32.kicad_pcb]
2025-04-07 length match some lines
    [stm32.kicad_pcb]
